estmaycolarevalo-dot/Parcial/video/README.md

# Video de demostración
Enlace del video:
https://drive.google.com/file/d/1YeeuwiZ78a70u5UPMqhn5FjHnYobzh1j/view?usp=sharing
