estmaycolarevalo-dot/Parcial/02_banda_transportadora/cad_salida/render_interior.png

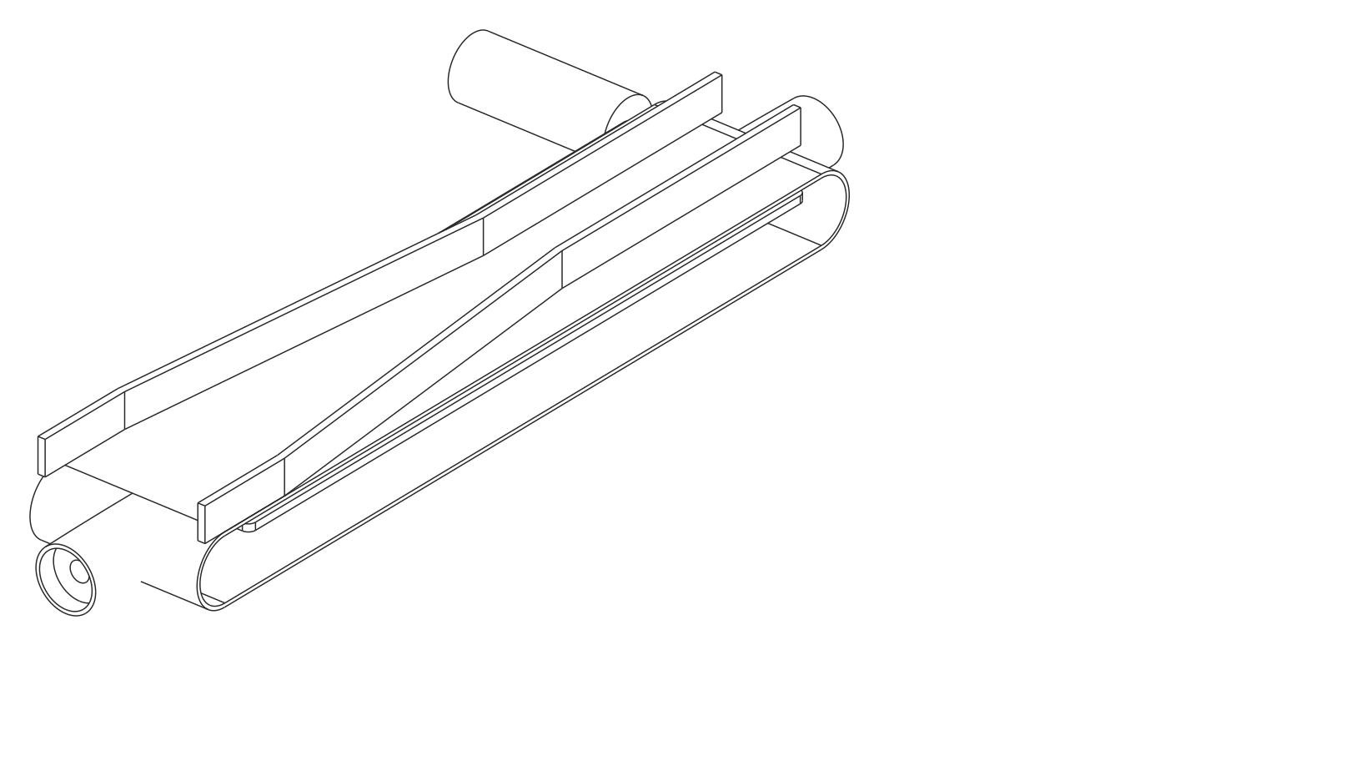
02_banda_transportadora/cad_salida/render_interior.png
