estmaycolarevalo-dot/Parcial/02_banda_transportadora/cad_salida/render_isometrico.png

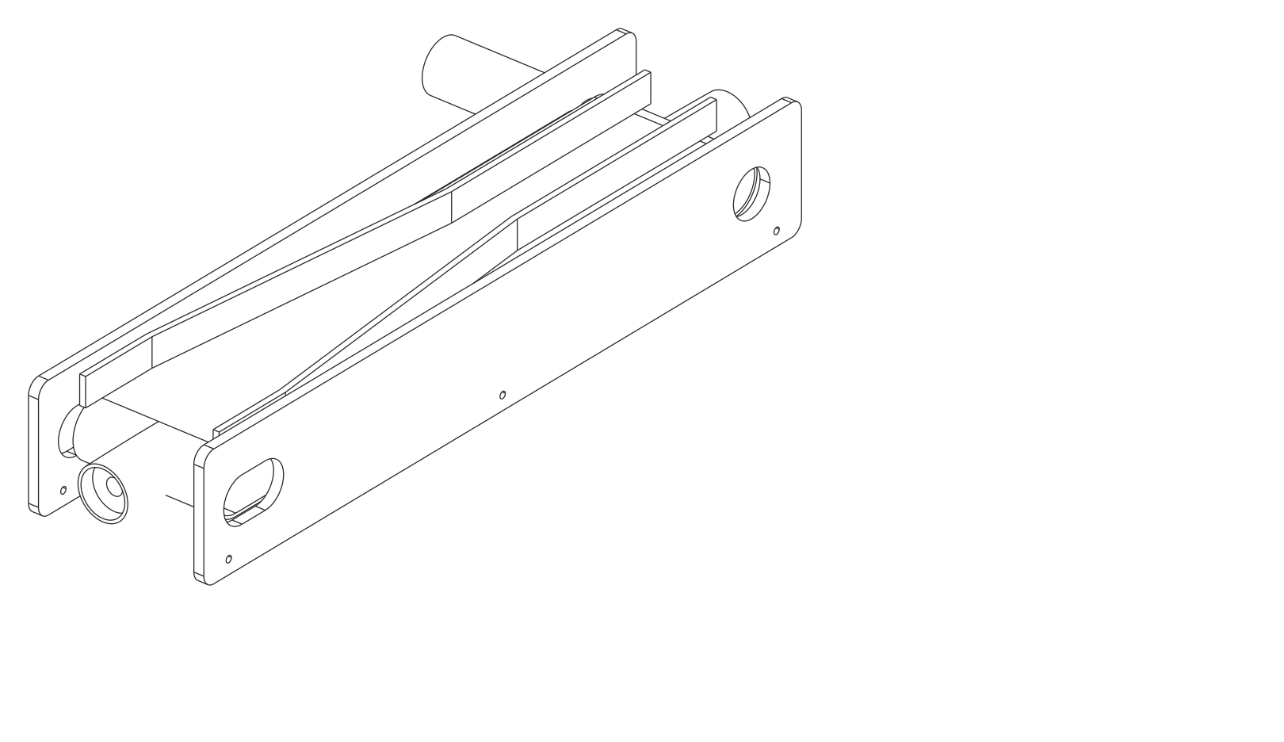
02_banda_transportadora/cad_salida/render_isometrico.png
