estmaycolarevalo-dot/Parcial/02_banda_transportadora/esquemas/arquitectura_electrica.png

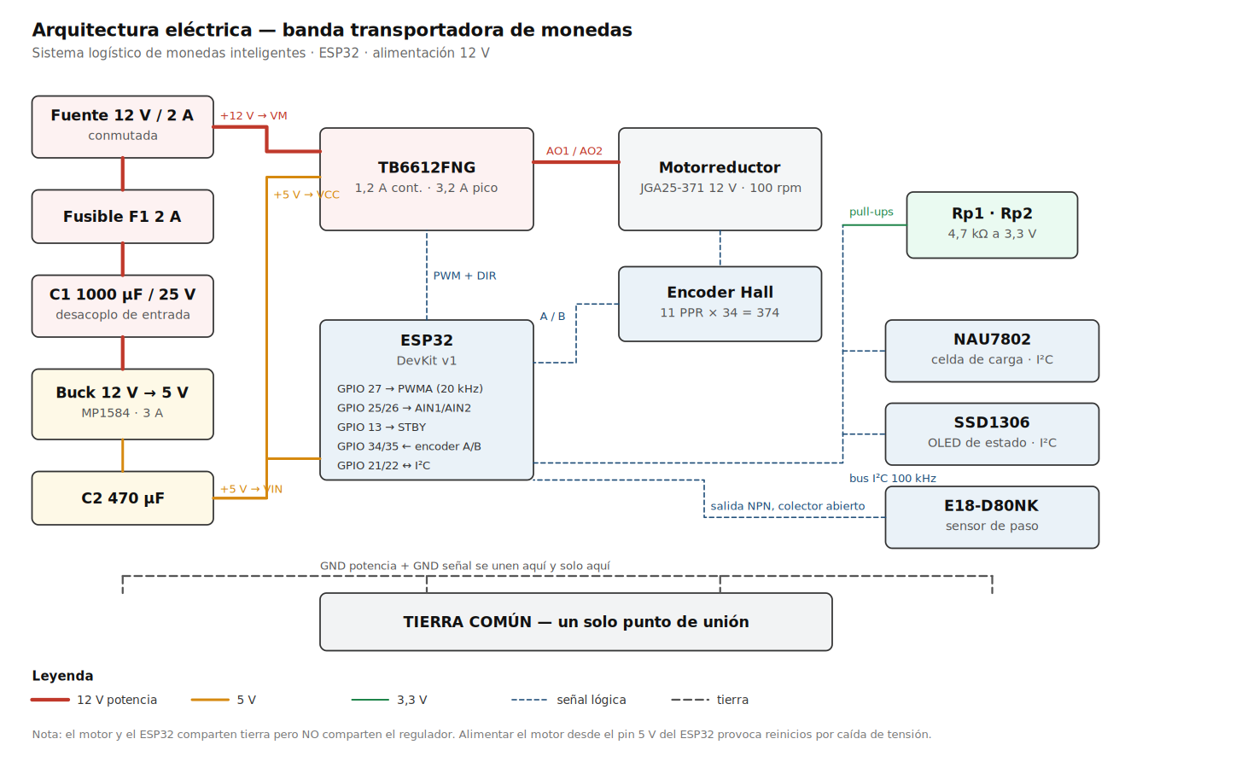
02_banda_transportadora/esquemas/arquitectura_electrica.png
