estmaycolarevalo-dot/Parcial/02_banda_transportadora/esquemas/arquitectura_electrica_economica.png

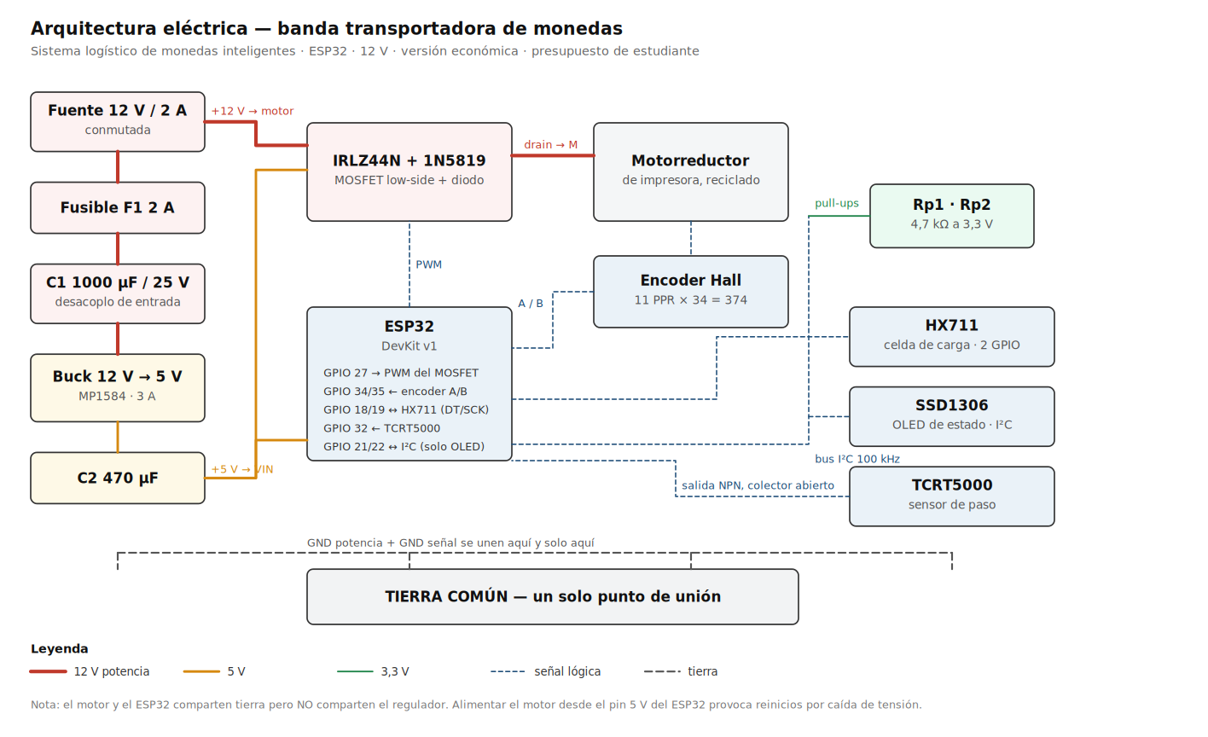
02_banda_transportadora/esquemas/arquitectura_electrica_economica.png
