estmaycolarevalo-dot/Parcial/docs/02_urdf_base_docente.png

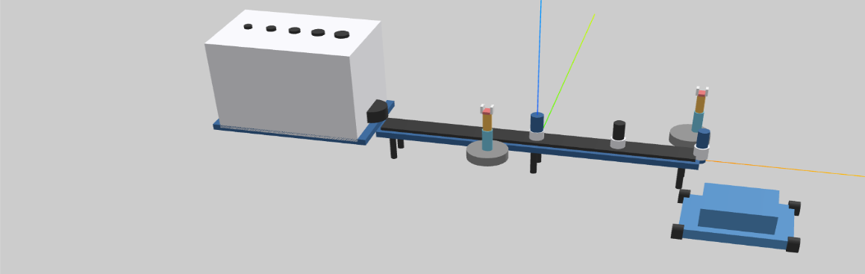
docs/02_urdf_base_docente.png
