estmaycolarevalo-dot/Parcial/02_banda_transportadora/cad_salida/banda_ensamblaje.step

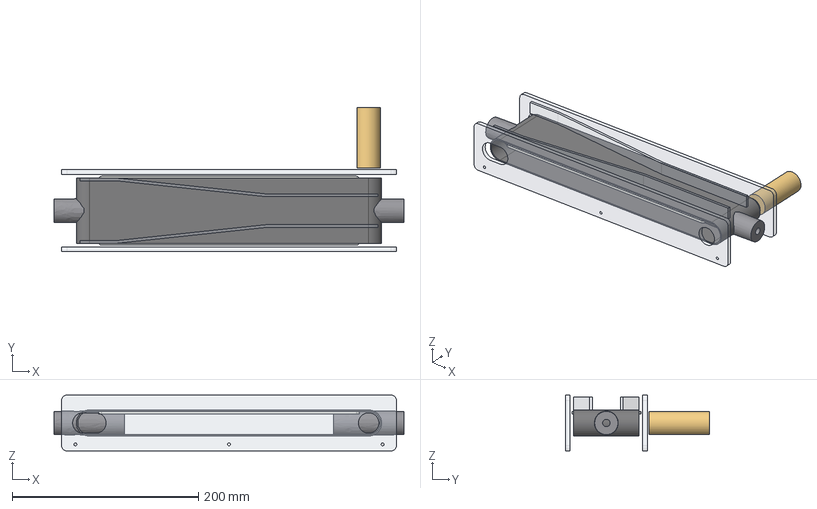
[picture p9: CAD file, 2026-10-05]
02_banda_transportadora/cad_salida/banda_ensamblaje.step
376.0 x 155.0 x 60.0 mm
rodillo_motriz
rodillo_tensor
lateral_der
lateral_izq
placa_apoyo
guia_der
guia_izq
cinta
motorreductor
