estmaycolarevalo-dot/Parcial/02_banda_transportadora/cad_salida/piezas_step/rodillo_tensor.step

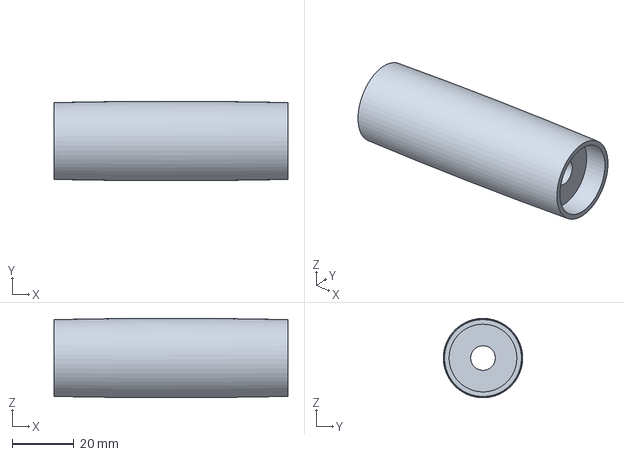
[picture p10: CAD file, 2026-10-05]
02_banda_transportadora/cad_salida/piezas_step/rodillo_tensor.step
76.0 x 25.8 x 25.8 mm
