estmaycolarevalo-dot/Parcial/02_banda_transportadora/cad_salida/stl/guia_der.stl

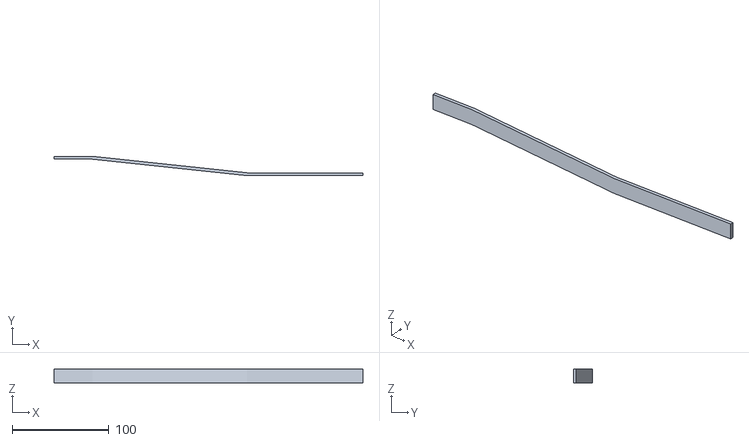
[picture p11: CAD file, 2026-10-05]
02_banda_transportadora/cad_salida/stl/guia_der.stl
320.0 x 20.0 x 14.0
