estmaycolarevalo-dot/Parcial/02_banda_transportadora/cad_salida/stl/placa_apoyo.stl

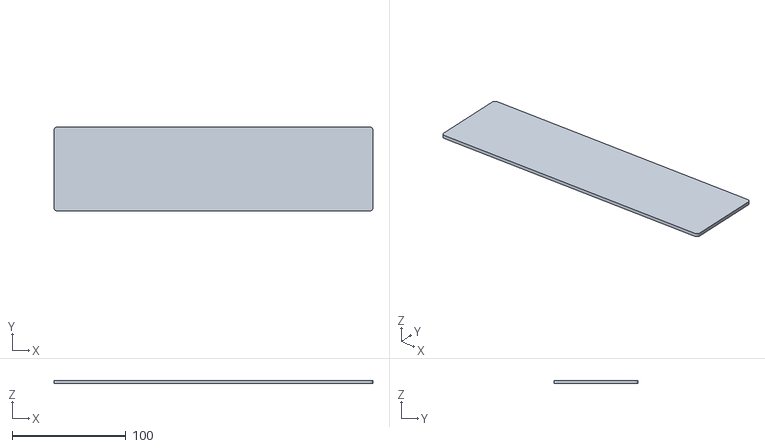
[picture p13: CAD file, 2026-10-05]
02_banda_transportadora/cad_salida/stl/placa_apoyo.stl
280.0 x 74.0 x 3.00
