estmaycolarevalo-dot/Parcial/02_banda_transportadora/cad_salida/piezas_step/placa_lateral.step

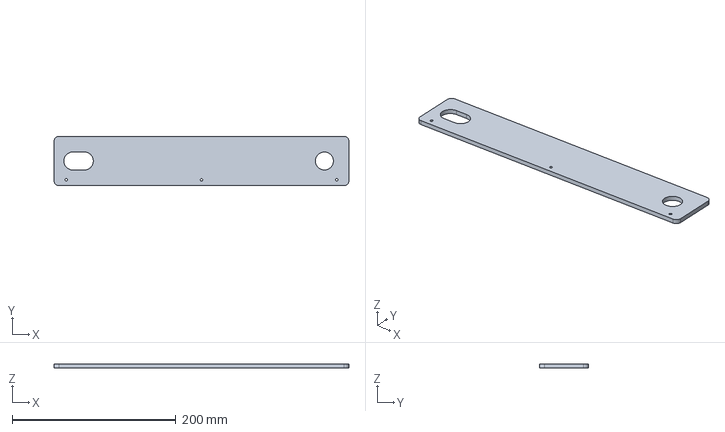
[picture p14: CAD file, 2026-10-05]
02_banda_transportadora/cad_salida/piezas_step/placa_lateral.step
360.0 x 60.0 x 5.00 mm
