estmaycolarevalo-dot/Parcial/(list of files, cad)

Other CAD files:
02_banda_transportadora/cad_salida/piezas_step/guia_izq.step
02_banda_transportadora/cad_salida/stl/guia_izq.stl
02_banda_transportadora/cad_salida/stl/placa_lateral.stl
02_banda_transportadora/cad_salida/piezas_step/guia_der.step
02_banda_transportadora/cad_salida/stl/rodillo_tensor.stl
02_banda_transportadora/cad_salida/piezas_step/placa_apoyo.step
02_banda_transportadora/cad_salida/stl/rodillo_motriz.stl
